XAUT-WisdomLab/stm32_car_drive/(list of files, drawings)

Other design files:
hardware/pcb/stm32_car_drive_v1.0.0/car.dsn
hardware/pcb/stm32_car_drive_v2.0.0/car.dsn
