XAUT-WisdomLab/stm32_car_drive/hardware/pcb/stm32_car_drive_v2.0.0/car.kicad_pcb

## KiCad design hardware/pcb/stm32_car_drive_v2.0.0/car.kicad_pcb (2024-06-29)

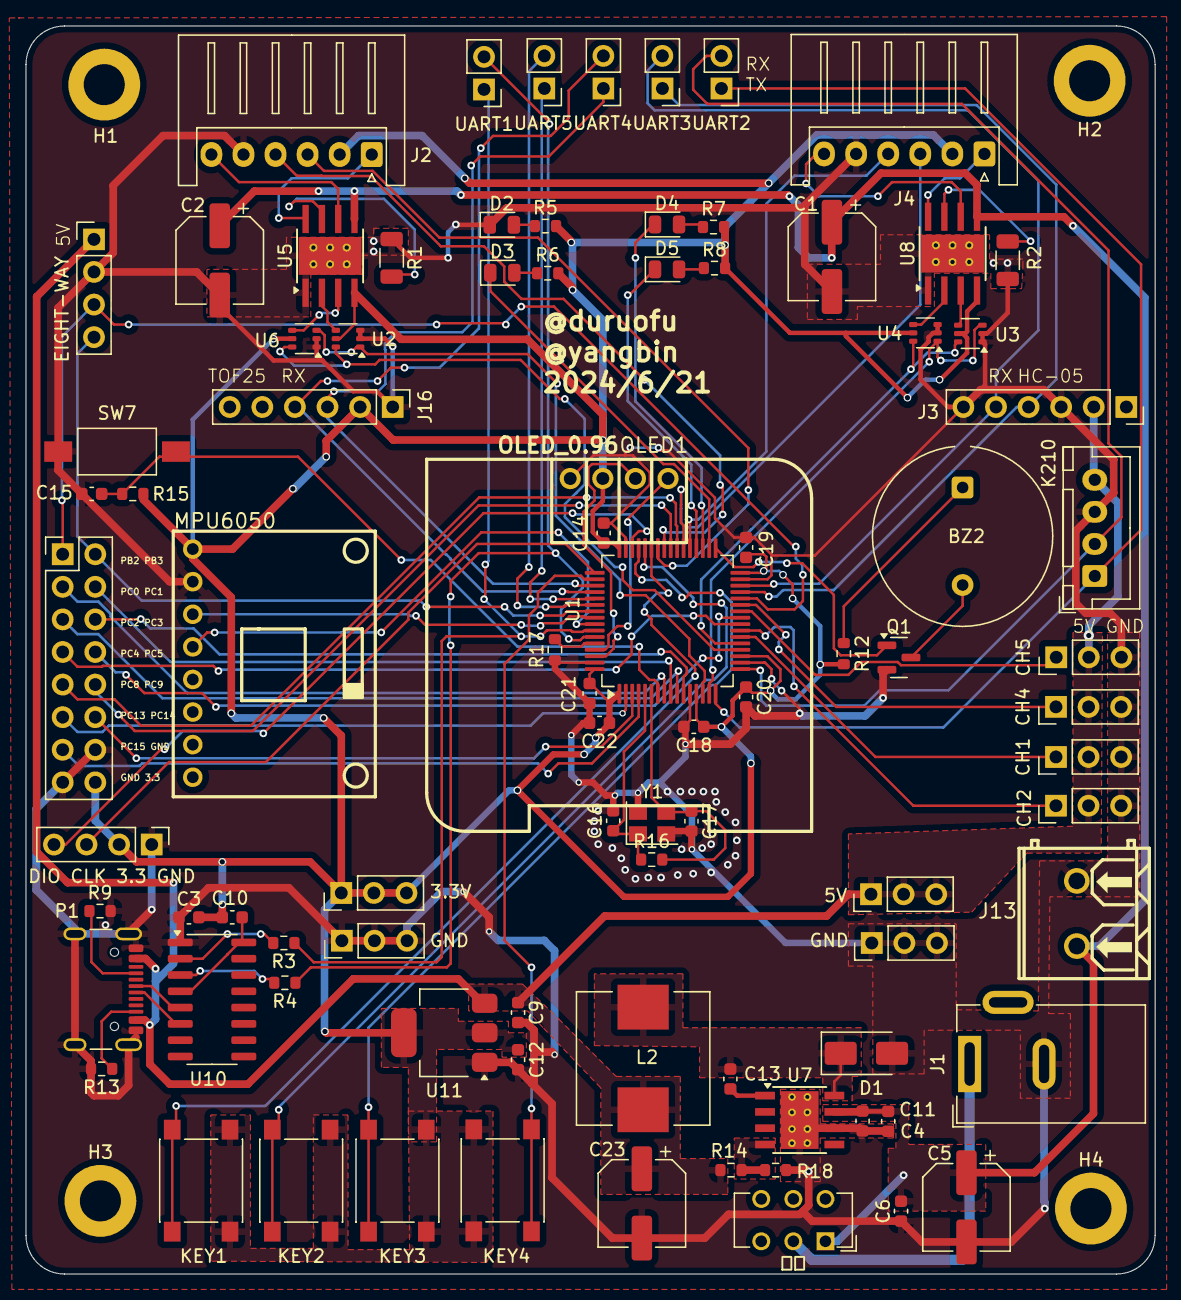
[picture p1: board hardware/pcb/stm32_car_drive_v2.0.0/car.kicad_pcb from above]

Board: 2 copper layers, 88.0 x 97.3 mm, 92 parts (0 on the bottom side), 84 nets.

Parts:
3.3V, 5V: Conn_01x03; PinHeader_1x03_P2.54mm_Vertical
BZ2: Buzzer; Indicator_PUI_AI-1440-TWT-24V-2-R
C1, C2: 100uf; CP_Elec_6.3x7.7
C3: 0.1uF; C_0603_1608Metric
C4, C11: 4.7uf; C_0603_1608Metric
C5, C23: 220uf; CP_Elec_6.3x7.7
C6, C10: 0.1uf; C_0603_1608Metric
C9, C12: 2.2uF; C_0603_1608Metric
C13: 0.01uf; C_0603_1608Metric
C14, C18, C19, C20, C21, C22: 0.1uf/16V; C_0603_1608Metric
C15: 0.1uF/50V; C_0603_1608Metric
C16, C17: 22pf/16V; C_0603_1608Metric
CH1, CH2, CH4, CH5: Conn_01x03; PinHeader_1x03_P2.54mm_Vertical
D1: B340; D_SMA
D2, D3, D4, D5: LED; LED_0805_2012Metric
DIO CLK 3.3 GND: Conn_01x04; PinHeader_1x04_P2.54mm_Vertical
EIGHT-WAY: Conn_01x04; PinHeader_1x04_P2.54mm_Vertical
GND: Conn_01x03; PinHeader_1x03_P2.54mm_Vertical
GND#2: Conn_01x03; PinHeader_1x03_P2.54mm_Vertical
H1, H2, H3, H4: MountingHole; MountingHole_3.2mm_M3_DIN965_Pad
J1: DC母座(大)
J2, J4: Conn_01x06; JST_XH_S6B-XH-A_1x06_P2.50mm_Horizontal
J3: HC-05; PinSocket_1x06_P2.54mm_Vertical
J13: Conn_01x02; CONN-TH_2P-P5.08
J16: HC-05; PinHeader_1x06_P2.54mm_Vertical
K210: Conn_01x04; JST_XH_B4B-XH-A_1x04_P2.50mm_Vertical
KEY1: K1; SW_Push_1P1T_NO_6x6mm
KEY2: K2; SW_Push_1P1T_NO_6x6mm
KEY3: K3; SW_Push_1P1T_NO_6x6mm
KEY4: K4; SW_Push_1P1T_NO_6x6mm
L2: 22uh; L_Wuerth_HCI-1040
MPU6050: Conn_01x08; MPU6050-GY-521
OLED1: OLED_0.96; 0.96OLED_4P
P1: USB_C_Plug_USB2.0; USB_C_Receptacle_GCT_USB4105-xx-A_16P_TopMnt_Horizontal
PB2 PB3: Conn_02x08_Counter_Clockwise; PinHeader_2x08_P2.54mm_Vertical
Q1: S8050; SOT-23
R1, R2: 0.15R 1206 1WOCP=3.3V/10/0.15R=2.2A; R_1206_3216Metric
R3, R4: 0; R_0603_1608Metric
R5, R6, R7, R8, R17: 10k; R_0603_1608Metric
R9, R13: 5.1K; R_0603_1608Metric
R12: 20; R_0603_1608Metric
R14: R; R_0603_1608Metric
R15: 10K; R_0603_1608Metric
R16: 1M; R_0603_1608Metric
R18: 3.2k; R_0603_1608Metric
SW7: RST; SW_SPST_FSMSM
U1: STM32F103RCTx; LQFP-64_10x10mm_P0.5mm
U2, U3, U4, U6: SOT-363_SC-70-6
U5, U8: DRV8870DDA; Texas_HTSOP-8-1EP_3.9x4.9mm_P1.27mm_EP2.95x4.9mm_Mask2.4x3.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
U7: TPS5430DDA; TI_SO-PowerPAD-8_ThermalVias
U10: CH340C; SOIC-16_3.9x9.9mm_P1.27mm
U11: SGM2212-3.3XKC3G/TR; SOT-223
UART1, UART2, UART3, UART4, UART5: Conn_01x02; PinHeader_1x02_P2.54mm_Vertical
Y1: Crystal_GND24(8M); Crystal_SMD_3225-4Pin_3.2x2.5mm
电源: SW_Push_SPDT; SW_CuK_JS202011CQN_DPDT_Straight

Connections:
+3.3V: 3.3V.1, 3.3V.2, 3.3V.3, C3.2, C10.2, C12.1, C14.1, C18.1, C19.1, C20.1, C21.1, C22.1, DIO CLK 3.3 GND.2, J2.2, J4.2, J16.2, KEY1.2, KEY2.2, KEY3.2, KEY4.2, MPU6050.1, OLED1.2 (VCC), PB2 PB3.16, R5.2, R6.2, R7.2, R8.2, R12.2, R15.2, U1.1 (VBAT), U1.13 (VDDA), U1.19 (VDD), U1.32 (VDD), U1.48 (VDD), U1.64 (VDD), U2.5, U3.5, U4.5, U5.4 (VREF), U6.5, U8.4 (VREF), U11.2 (VOUT), U11.4 (VOUT)
+5V: 5V.1, 5V.2, 5V.3, C9.1, C23.1, CH1.2, CH2.2, CH4.2, CH5.2, EIGHT-WAY.1, J3.2, K210.4, L2.2, P1.A4 (VBUS), P1.A9 (VBUS), P1.B4 (VBUS), P1.B9 (VBUS), R14.1, U11.3 (VIN)
+12V: C1.1, C2.1, C4.2, C5.1, C6.2, C11.2, J13.1, U5.5 (VM), U7.7 (VIN), U8.5 (VM), 电源.1 (A)
/-PB2: EIGHT-WAY.3, PB2 PB3.1, U1.28 (PB2)
/-PB3: EIGHT-WAY.4, PB2 PB3.2, U1.55 (PB3)
/-PC0: PB2 PB3.3, U1.8 (PC0)
/-PC1: PB2 PB3.4, U1.9 (PC1)
/-PC2: PB2 PB3.5, U1.10 (PC2)
/-PC3: PB2 PB3.6, U1.11 (PC3)
/-PC4: PB2 PB3.7, U1.24 (PC4)
/-PC5: PB2 PB3.8, U1.25 (PC5)
/-PC8: PB2 PB3.9, U1.39 (PC8)
/-PC9: PB2 PB3.10, U1.40 (PC9)
/-PC13: PB2 PB3.11, U1.2 (PC13)
/-PC14: PB2 PB3.12, U1.3 (PC14)
/-PC15: PB2 PB3.13, U1.4 (PC15)
/Buzzer: Q1.1 (B), U1.33 (PB12)
/DIRA: U1.20 (PA4), U2.6, U6.6
/DIRB: U1.21 (PA5), U3.6, U4.6
/KEY1: KEY1.1, U1.43 (PA10)
/KEY2: KEY2.1, U1.44 (PA11)
/KEY3: KEY3.1, U1.45 (PA12)
/KEY4: KEY4.1, U1.50 (PA15)
/LED1: D3.1 (K), U1.34 (PB13)
/LED2: D4.1 (K), U1.35 (PB14)
/LED3: D5.1 (K), U1.36 (PB15)
/MPU_SCL: MPU6050.3, U1.56 (PB4)
/MPU_SDA: MPU6050.4, U1.57 (PB5)
/OLED_ACL: OLED1.3 (SCL), U1.62 (PB9)
/OLED_SDA: OLED1.4 (SDA), U1.61 (PB8)
/TIM1_CH1: J2.4, U1.41 (PA8)
/TIM1_CH2: J2.3, U1.42 (PA9)
/TIM2_CH1: U1.14 (PA0), U2.1, U6.3
/TIM2_CH2: U1.15 (PA1), U3.3, U4.1
/TIM3_CH1: CH1.1, U1.22 (PA6)
/TIM3_CH2: CH2.1, U1.23 (PA7)
/TIM3_CH3: CH5.1, U1.26 (PB0)
/TIM3_CH4: CH4.1, U1.27 (PB1)
/TIM8_CH1: J4.4, U1.37 (PC6)
/TIM8_CH2: J4.3, U1.38 (PC7)
/USART1_RX: R4.1, U1.59 (PB7), UART1.2
/USART1_TX: R3.1, U1.58 (PB6), UART1.1
/USART2_RX: K210.2, U1.17 (PA3), UART2.2
/USART2_TX: K210.1, U1.16 (PA2), UART2.1
/USART3_RX: J3.5, U1.30 (PB11), UART3.2
/USART3_TX: J3.4, U1.29 (PB10), UART3.1
/USART4_RX: J16.4, U1.52 (PC11), UART4.2
/USART4_TX: J16.3, U1.51 (PC10), UART4.1
/USART5_RX: U1.54 (PD2), UART5.2
/USART5_TX: U1.53 (PC12), UART5.1
/bb68942b/AOUT1: J2.6, U5.6 (OUT1)
/bb68942b/AOUT2: J2.1, U5.8 (OUT2)
/bb68942b/BOUT1: J4.6, U8.6 (OUT1)
/bb68942b/BOUT2: J4.1, U8.8 (OUT2)
/stm32f103rct6/BOOT0: R17.2, U1.60 (BOOT0)
/stm32f103rct6/OSC_IN: C16.1, R16.1, U1.5 (PD0), Y1.1
/stm32f103rct6/OSC_OUT: C17.1, R16.2, U1.6 (PD1), Y1.3
/stm32f103rct6/RST: C15.2, R15.1, SW7.2, U1.7 (NRST)
/stm32f103rct6/SWCLK: DIO CLK 3.3 GND.3, U1.49 (PA14)
/stm32f103rct6/SWDIO: DIO CLK 3.3 GND.4, U1.46 (PA13)
GND: C1.2, C2.2, C3.1, C4.1, C5.2, C6.1, C9.2, C11.1, C12.2, C14.2, C15.1, C16.2, C17.2, C18.2, C19.2, C20.2, C21.2, C22.2, C23.2, CH1.3, CH2.3, CH4.3, CH5.3, D1.2 (A), D2.1 (K), DIO CLK 3.3 GND.1, EIGHT-WAY.2, GND.1, GND.2, GND.3, GND#2.1, GND#2.2, GND#2.3, J1.2, J2.5, J3.3, J3.6, J4.5, J13.2, J16.1, K210.3, MPU6050.2, OLED1.1 (GND), P1.A1 (GND), P1.A12 (GND), P1.B1 (GND), P1.B12 (GND), P1.S1 (SHIELD), PB2 PB3.14, PB2 PB3.15, Q1.2 (E), R1.1, R2.1, R9.2, R13.2, R17.1, R18.2, SW7.1, U1.12 (VSSA), U1.18 (VSS), U1.31 (VSS), U1.47 (VSS), U1.63 (VSS), U2.2, U2.3, U3.1, U3.2, U4.2, U4.3, U5.1 (GND), U5.9 (GND), U6.1, U6.2, U7.6 (GND), U7.9 (GNDPAD), U8.1 (GND), U8.9 (GND), U10.1 (GND), U11.1 (GND), Y1.2, Y1.4
unnamed: BZ2.2 (+), Q1.3 (C)
unnamed: BZ2.1 (-), R12.1
unnamed: C13.2, D1.1 (K), L2.1, U7.8 (PH)
unnamed: D2.2 (A), R5.1
unnamed: D3.2 (A), R6.1
unnamed: D4.2 (A), R7.1
unnamed: D5.2 (A), R8.1
unnamed: P1.A5 (CC), R9.1
unnamed: P1.A6 (D+), U10.5 (UD+)
unnamed: P1.A7 (D-), U10.6 (UD-)
unnamed: P1.B5 (VCONN), R13.1
unnamed: J1.1, 电源.2 (B)
unnamed: U5.3 (IN1), U6.4
unnamed: U2.4, U5.2 (IN2)
unnamed: R1.2, U5.7 (ISEN)
unnamed: C13.1, U7.1 (BOOT)
unnamed: R14.2, R18.1, U7.4 (VSENSE)
unnamed: U3.4, U8.3 (IN1)
unnamed: U4.4, U8.2 (IN2)
unnamed: R2.2, U8.7 (ISEN)
unnamed: R4.2, U10.3 (RXD)
unnamed: R3.2, U10.2 (TXD)
unnamed: C10.1, U10.4 (V3), U10.16 (VCC)
