XAUT-WisdomLab/stm32_car_drive/software/rct6/template.ioc

Mcu.UserName=STM32F103RCTx
PA0-WKUP.Signal=S_TIM2_CH1_ETR
PA1.Signal=S_TIM2_CH2
PA10.GPIO_Label=KEY1
PA10.Signal=GPXTI10
PA11.GPIO_Label=KEY2
PA11.Signal=GPXTI11
PA12.GPIO_Label=KEY3
PA12.Signal=GPXTI12
PA13.Signal=SYS_JTMS-SWDIO
PA14.Signal=SYS_JTCK-SWCLK
PA15.GPIO_Label=KEY4
PA15.Signal=GPXTI15
PA2.Signal=USART2_TX
PA3.Signal=USART2_RX
PA4.Signal=GPIO_Output
PA5.Signal=GPIO_Output
PA6.Signal=S_TIM3_CH1
PA7.Signal=S_TIM3_CH2
PA8.Signal=S_TIM1_CH1
PA9.Signal=S_TIM1_CH2
PB0.Signal=S_TIM3_CH3
PB1.Signal=S_TIM3_CH4
PB10.Signal=USART3_TX
PB11.Signal=USART3_RX
PB13.GPIO_Label=LED1
PB13.Signal=GPIO_Output
PB14.GPIO_Label=LED2
PB14.Signal=GPIO_Output
PB15.GPIO_Label=LED3
PB15.Signal=GPIO_Output
PB6.Signal=USART1_TX
PB7.Signal=USART1_RX
PB8.GPIO_Label=I2C_SDA
PB8.Signal=GPIO_Output
PB9.GPIO_Label=I2C_SCL
PB9.Signal=GPIO_Output
PC10.Signal=UART4_TX
PC11.Signal=UART4_RX
PC12.Signal=UART5_TX
PC13-TAMPER-RTC.Signal=GPIO_Output
PC14-OSC32_IN.Signal=GPIO_Output
PC15-OSC32_OUT.Signal=GPIO_Output
PC6.Signal=S_TIM8_CH1
PC7.Signal=S_TIM8_CH2
PD0-OSC_IN.Signal=RCC_OSC_IN
PD1-OSC_OUT.Signal=RCC_OSC_OUT
PD2.Signal=UART5_RX
