XAUT-WisdomLab/stm32_car_drive/software/rct6/User/YunTai/yuntai.c

#include "yuntai.h"
#include "uart_1.h"
#include <math.h>

#define Servo_MAX_A 2000    //最大位置
#define Servo_MAX_B 2000

#define Servo_MIN_A 1000     //最小位置
#define Servo_MIN_B 1000

extern int32_t Servo_Kp = 0.5;            // 舵机比例系数
extern int32_t Servo_Ki = 0.8;            // 舵机积分系数
extern int32_t Servo_Kd = 0;            // 舵机微分系数


// 实时位置  
extern uint16_t pwm_A = 1450;
extern uint16_t pwm_B = 1773;

// 上一次控过的位置
uint16_t pwm_A_last = 1500;
uint16_t pwm_B_last = 1800;

extern int x_err ;
extern int y_err ;
void Yuntai_Init()
{
    SERVO_PWMA_Set(pwm_A);
    SERVO_PWMB_Set(pwm_B);
}

//云台控制
void Yuntai_Control(void)
{
    Yuntaiz_A_Move(pwm_A,0);
    Yuntaiz_B_Move(pwm_B,0);
}

//
void Yuntai_PID(void)
{
    static int16_t L_x_err=0,L_L_x_err=0,L_y_err=0,L_L_y_err=0;


    // 死区限制，防止抖动
    if (x_err > -3 && x_err < 3) x_err = 0,L_x_err=0,L_L_x_err=0,L_y_err=0,L_L_y_err=0;
    if (y_err > -3 && y_err < 3) y_err = 0,L_x_err=0,L_L_x_err=0,L_y_err=0,L_L_y_err=0;


    // 进行PID计算
    // -0.2 -0.8 -0.1
    // 0.2 0.8 0.1
//		pwm_B += -0.1 * (x_err-L_x_err);
    pwm_B += 0.2 * (x_err-L_x_err)+ (0.4)*x_err+ (0) * (x_err - 2 * L_x_err + L_L_x_err);
    pwm_A += 0.25 * (y_err-L_y_err) + (0.2)*y_err + 0* (y_err - 2 * L_y_err + L_L_y_err);
    

    //保存误差值
    L_x_err = x_err;
    L_L_x_err = L_x_err;
    
    L_y_err = y_err;
    L_L_x_err = L_y_err;

    //输出限幅
    if (pwm_A > Servo_MAX_A) pwm_A = Servo_MAX_A;
    if (pwm_A < Servo_MIN_A) pwm_A = Servo_MIN_A;
    if (pwm_B > Servo_MAX_B) pwm_B = Servo_MAX_B;
    if (pwm_B < Servo_MIN_B) pwm_B = Servo_MIN_B;

    // 进行控制
//    Yuntaiz_A_Move(pwm_A,0); //竖直
//    Yuntaiz_B_Move(pwm_B,0); //水平
		Yuntaiz_AB_Move_2(pwm_A,pwm_B,1);
}


//云台A(左右)丝滑移动,两个参数分别为目标位置和移动延时
void Yuntaiz_A_Move(uint16_t pwm_d,int16_t Flow_Coefficient)
{

    // 计算每次移动的步长
    int16_t step_a = (pwm_d > pwm_A_last) ? 1 : -1;
    while (pwm_A_last != pwm_d)
    {
        pwm_A_last += step_a;
        SERVO_PWMA_Set(pwm_A_last);
        HAL_Delay(Flow_Coefficient);
    }
}


// 云台B(上下)丝滑移动，两个参数分别为目标位置和移动延时
void Yuntaiz_B_Move(uint16_t pwm_d, int16_t Flow_Coefficient)
{

    // 计算每次移动的步长
    int16_t step_b = (pwm_d > pwm_B_last) ? 1 : -1;
    while (pwm_B_last != pwm_d)
    {
        pwm_B_last += step_b;
        SERVO_PWMB_Set(pwm_B_last);
        HAL_Delay(Flow_Coefficient);
    }
}


// 走斜线(不考虑斜率)
// 云台B(上下)丝滑移动，三个参数分别为目标位置和移动延时
void Yuntaiz_AB_Move(uint16_t pwm_a,uint16_t pwm_b, int16_t Flow_Coefficient)
{

    // 计算每次移动的步长
    int16_t step_a = (pwm_a > pwm_A_last) ? 1 : -1;
    int16_t step_b = (pwm_b > pwm_B_last) ? 1 : -1;
    
    // 按照步长移动云台A和云台B，直到达到目标位置
    while (pwm_A_last != pwm_a || pwm_B_last != pwm_b)
    {
        if (pwm_A_last != pwm_a)
        {
            pwm_A_last += step_a;
            SERVO_PWMA_Set(pwm_A_last);
        }
        if (pwm_B_last != pwm_b)
        {
            pwm_B_last += step_b;
            SERVO_PWMB_Set(pwm_B_last);
        }
        HAL_Delay(Flow_Coefficient);
    }
}




// A4靶纸开环循迹(水平摆放)
void Yuntai_A4_Track(uint16_t pwm_a,uint16_t pwm_b, int16_t Flow_Coefficient)
{
    int16_t left_error = 170; //左右偏
    int16_t up_error = 118; //上下偏

    //坐标换算

    //移动到起始点
    Yuntaiz_AB_Move(pwm_a,pwm_b,Flow_Coefficient);
    //移动到第一个点
    Yuntaiz_AB_Move(pwm_a-left_error,pwm_b,Flow_Coefficient);
    //移动到第二个点
    Yuntaiz_AB_Move(pwm_a-left_error,pwm_b+up_error,Flow_Coefficient);
    //移动到第三个点
    Yuntaiz_AB_Move(pwm_a,pwm_b+up_error,Flow_Coefficient);
    //移动到第四个点
    Yuntaiz_AB_Move(pwm_a,pwm_b,Flow_Coefficient);
}

int abs(int num) {
    return (num < 0) ? -num : num;
}




//// 云台B(上下)丝滑移动，三个参数分别为目标位置和移动延时（考虑斜率）
void Yuntaiz_AB_Move_1(uint16_t x0, uint16_t y0,uint16_t x1, uint16_t y1, uint16_t pwm_a, uint16_t pwm_b,int16_t Flow_Coefficient)
{

		
		    // 计算云台A和云台B的位置差
    int16_t diff_a = abs(pwm_a - pwm_A_last);
    int16_t diff_b = abs(pwm_b - pwm_B_last);
    // 计算移动次数
    int16_t num_steps = (diff_a > diff_b)?diff_a:diff_b;
    

    // 计算云台A和云台B每次移动的增量
    float increment_a = (float)(pwm_a - pwm_A_last) / num_steps;
    float increment_b = (float)(pwm_b - pwm_B_last) / num_steps;
    
    DEBUG_info ("yuntai","increment_a:%f,increment_b:%f",increment_a,increment_b);

    

    // 插值移动云台A和云台B，直到达到目标位置
    for (int16_t i = 0; i <= num_steps; i++)
    {
        // 计算当前位置
        uint16_t current_pwm_a = round(pwm_A_last + i * increment_a);
        uint16_t current_pwm_b = round(pwm_B_last + i * increment_b);

        // 设置云台A和云台B的位置
        SERVO_PWMA_Set(current_pwm_a);
        SERVO_PWMB_Set(current_pwm_b);

        // 延时一段时间
        HAL_Delay(Flow_Coefficient);
    }

    // 更新云台A和云台B的最新位置
    pwm_A_last = pwm_a;
    pwm_B_last = pwm_b;
}


// 云台B(上下)丝滑移动，三个参数分别为目标位置和移动延时（考虑斜率）
void Yuntaiz_AB_Move_2(uint16_t pwm_a, uint16_t pwm_b, int16_t Flow_Coefficient)
{
    // 计算云台A和云台B的位置差
    int16_t diff_a = abs(pwm_a - pwm_A_last);
    int16_t diff_b = abs(pwm_b - pwm_B_last);

    // 计算移动次数
    int16_t num_steps  = (diff_a > diff_b) ? diff_a : diff_b;
    num_steps = num_steps* 3;

    if (num_steps == 0)
        return;  // 无需移动，直接返回

    // 计算云台A和云台B每次移动的增量
    float increment_a = (float)(pwm_a - pwm_A_last) / num_steps;
    float increment_b = (float)(pwm_b - pwm_B_last) / num_steps;

    DEBUG_info("yuntai", "increment_a:%f,increment_b:%f", increment_a, increment_b);

    // 计算延时时间
    uint32_t delay_time = Flow_Coefficient / num_steps;

    // 插值移动云台A和云台B，直到达到目标位置
    for (int16_t i = 0; i <= num_steps; i++)
    {
        // 计算当前位置
        uint16_t current_pwm_a = round(pwm_A_last + i * increment_a);
        uint16_t current_pwm_b = round(pwm_B_last + i * increment_b);

        // 设置云台A和云台B的位置
        SERVO_PWMA_Set(current_pwm_a);
        SERVO_PWMB_Set(current_pwm_b);

        // 延时一段时间
        HAL_Delay(delay_time);
    }

    // 更新云台A和云台B的最新位置
    pwm_A_last = pwm_a;
    pwm_B_last = pwm_b;
}





void Yuntaiz_AB_Move_3(uint16_t pwm_a, uint16_t pwm_b, int16_t Flow_Coefficient)
{
    // 定义云台A和云台B的最新位置变量
    uint16_t pwm_A_last = 0;
    uint16_t pwm_B_last = 0;
    // 计算云台A和云台B的位置差
    int16_t diff_a = abs(pwm_a - pwm_A_last); //水平方向
    int16_t diff_b = abs(pwm_b - pwm_B_last); //竖直方向

    // 计算移动次数
    int16_t num_steps = (diff_a > diff_b) ? diff_a : diff_b;

    // 计算加速度和减速度所需的步数
    int16_t accel_steps = num_steps / 2;
    int16_t decel_steps = num_steps - accel_steps;

    // 计算加速度和减速度阶段的增量
    float accel_increment_a = (float)(pwm_a - pwm_A_last) / accel_steps;
    float accel_increment_b = (float)(pwm_b - pwm_B_last) / accel_steps;
    
    float decel_increment_a = (float)(pwm_a - pwm_A_last - accel_increment_a * accel_steps) / decel_steps;
    float decel_increment_b = (float)(pwm_b - pwm_B_last - accel_increment_b * accel_steps) / decel_steps;

    // 插值移动云台A和云台B，直到达到目标位置
    for (int16_t i = 0; i <= num_steps; i++)
    {
        // 计算当前位置
        uint16_t current_pwm_a;
        uint16_t current_pwm_b;

        if (i < accel_steps)
        {
            // 加速阶段
            current_pwm_a = round(pwm_A_last + i * accel_increment_a);
            current_pwm_b = round(pwm_B_last + i * accel_increment_b);
        }
        else if (i >= num_steps - decel_steps)
        {
            // 减速阶段
            int16_t decel_index = i - (num_steps - decel_steps);
            current_pwm_a = round(pwm_A_last + accel_steps * accel_increment_a + decel_index * decel_increment_a);
            current_pwm_b = round(pwm_B_last + accel_steps * accel_increment_b + decel_index * decel_increment_b);
        }
        else
        {
            // 匀速阶段
            current_pwm_a = round(pwm_A_last + accel_steps * accel_increment_a + (i - accel_steps) * accel_increment_a * decel_steps);
            current_pwm_b = round(pwm_B_last + accel_steps * accel_increment_b + (i - accel_steps) * accel_increment_b * decel_steps);
        }

        // 设置云台A和云台B的位置
        SERVO_PWMA_Set(current_pwm_a);
        SERVO_PWMB_Set(current_pwm_b);

        // 延时一段时间
        HAL_Delay(Flow_Coefficient);
    }

    // 更新云台A和云台B的最新位置
    pwm_A_last = pwm_a;
    pwm_B_last = pwm_b;
}
