XAUT-WisdomLab/stm32_car_drive/(commit log)

2024-05-23 feat(pcb): update v2.0.0
    [bb68942b.kicad_sch, car.dsn, car.kicad_pcb, car.kicad_sch, power.kicad_sch, stm32f103rct6.kicad_sch]
2024-06-18 feat(pcb): 更新PCB封装
    [car.kicad_pcb, car.kicad_sch, power.kicad_sch]
2024-06-18 feat(pcb):更新布局
    [car.kicad_pcb, car.kicad_sch, power.kicad_sch, stm32f103rct6.kicad_sch]
2024-06-22 feat: 生成生产文件
    [BOM-car.csv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]
2024-06-22 追加修改
    [car.kicad_pcb]
2024-07-12 蜂鸣器+电机+编码器
